9Pierrot/Espace_de_travail_phoenix/images/capteur_de_flamme.png

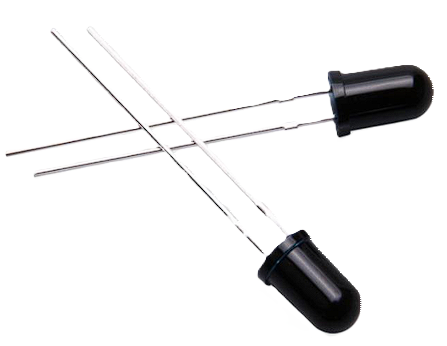
images/capteur_de_flamme.png
