9Pierrot/Espace_de_travail_phoenix/images/circuit.jpg

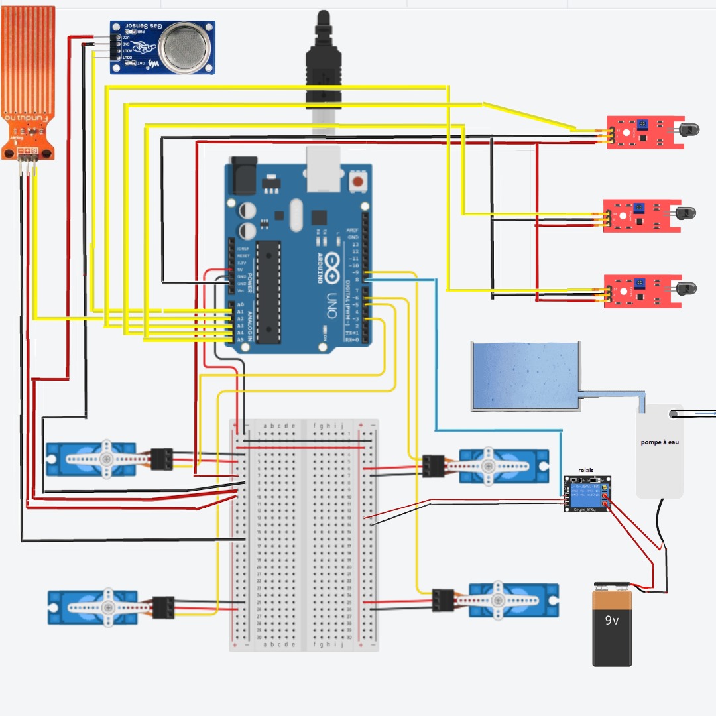
images/circuit.jpg
