9Pierrot/Espace_de_travail_phoenix/images/circuit_servo.png

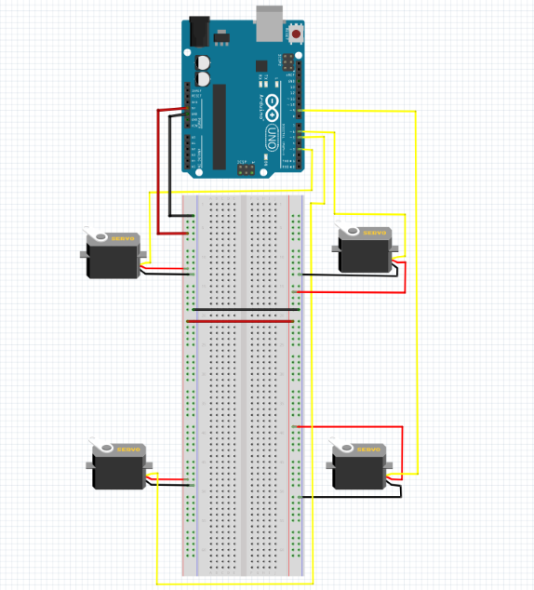
images/circuit_servo.png
