9Pierrot/Espace_de_travail_phoenix/images/dispositif_vue_angle.jpg

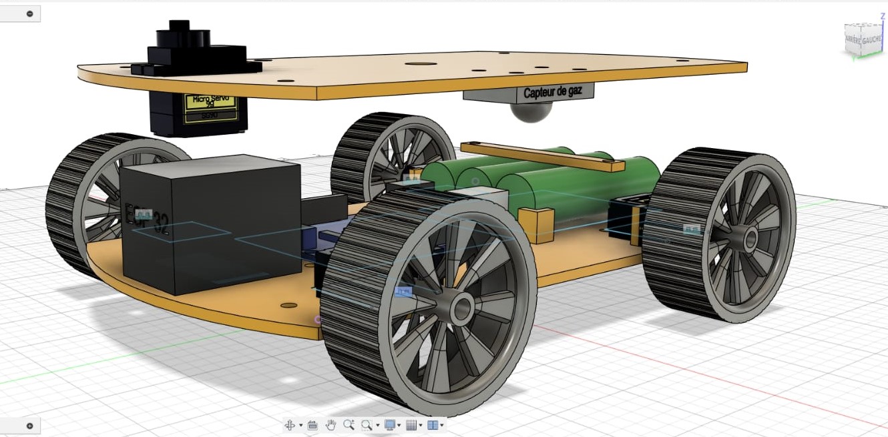
images/dispositif_vue_angle.jpg
