9Pierrot/Espace_de_travail_phoenix/images/etage_1(1).png

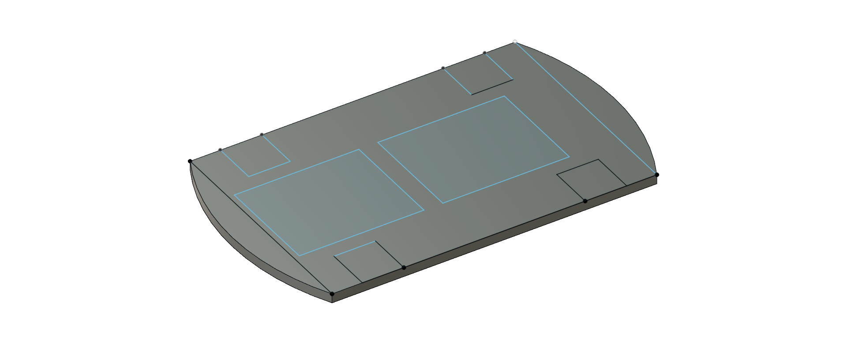
images/etage_1(1).png
