9Pierrot/Espace_de_travail_phoenix/images/etage_1.jpg

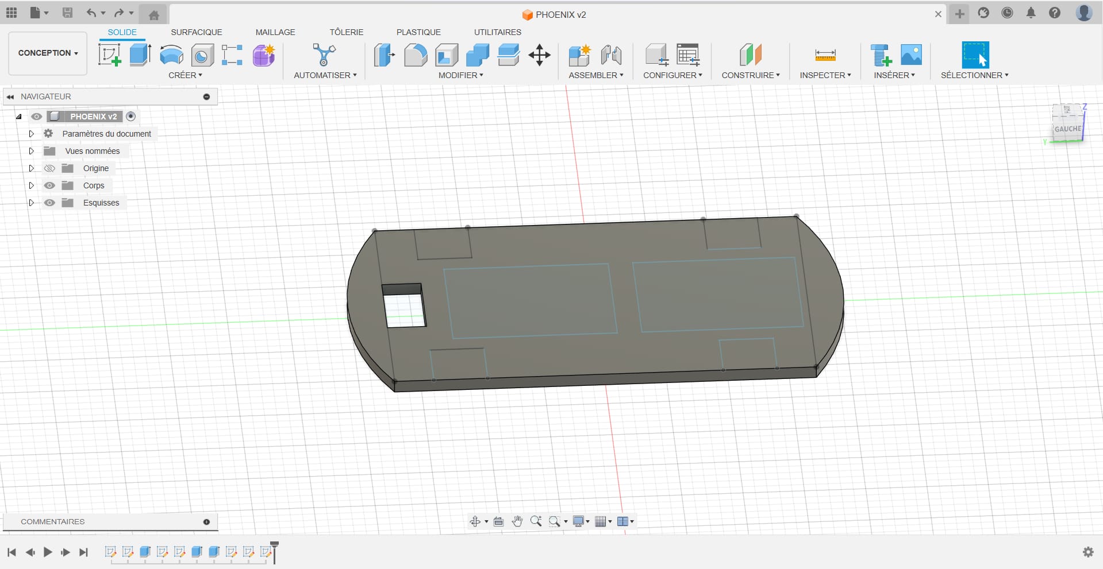
images/etage_1.jpg
