9Pierrot/Espace_de_travail_phoenix/images/etage_2.jpg

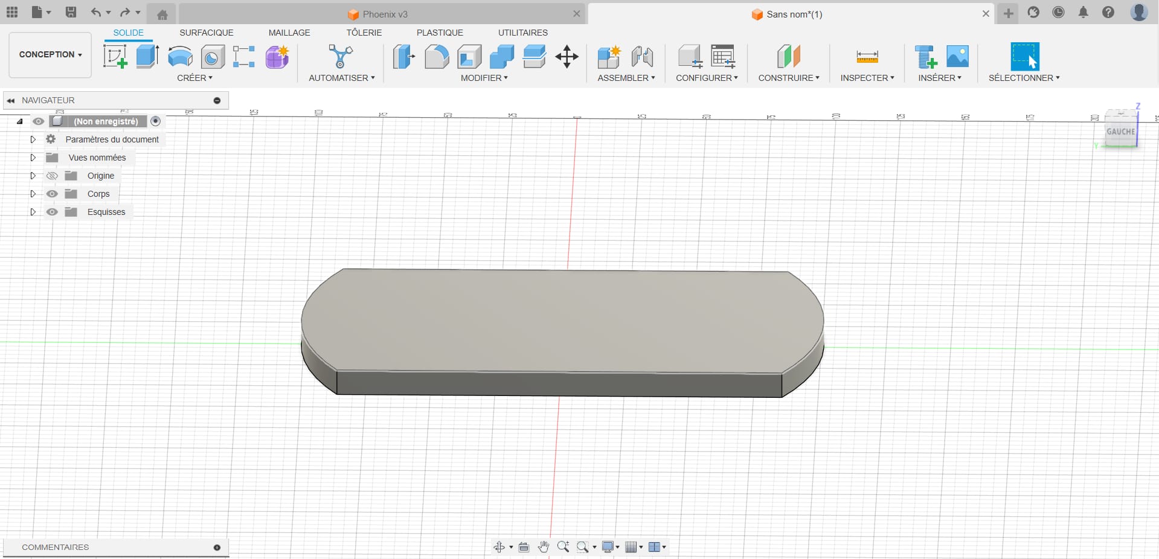
images/etage_2.jpg
