9Pierrot/Espace_de_travail_phoenix/images/img.png

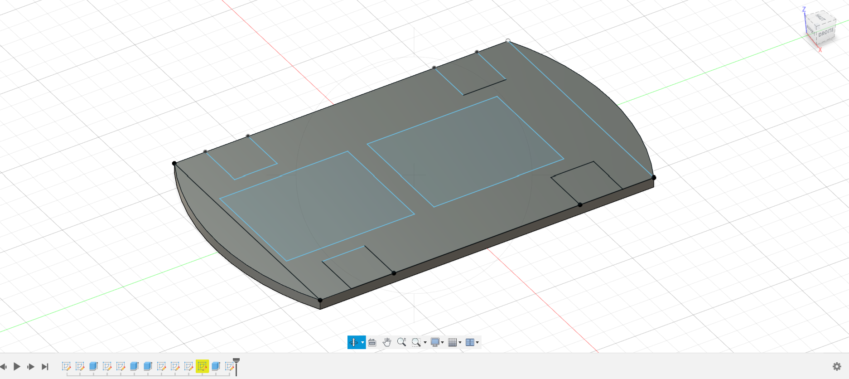
images/img.png
