9Pierrot/Espace_de_travail_phoenix/images/IMG_2295.JPG

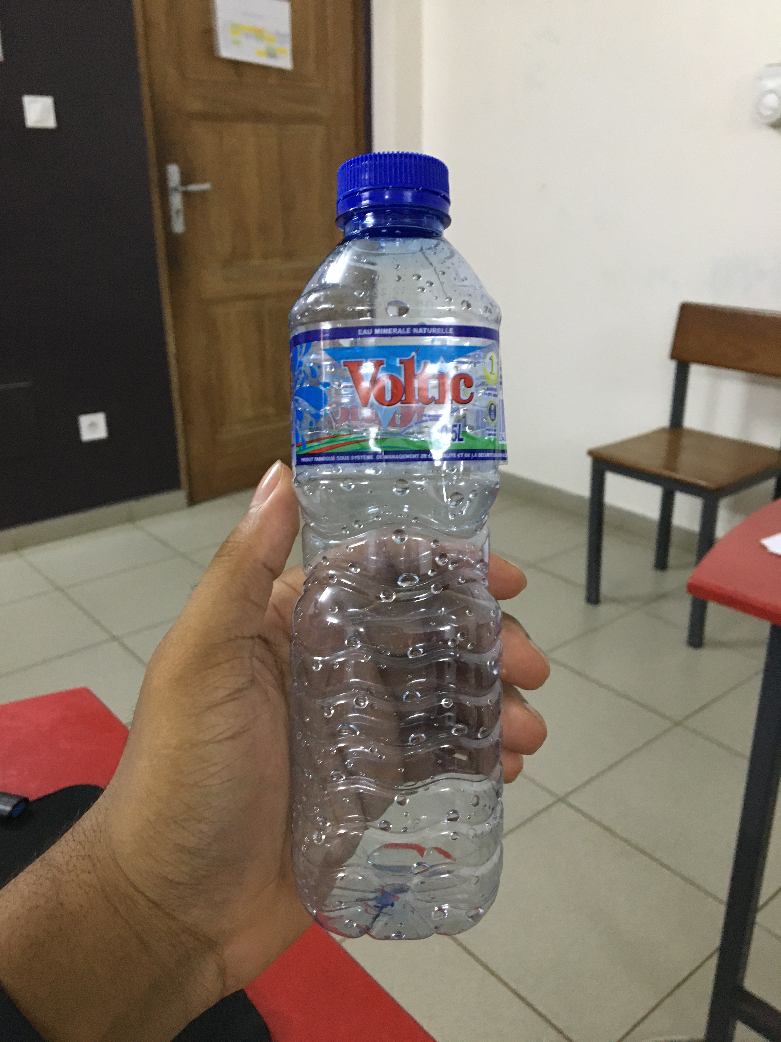
images/IMG_2295.JPG
