9Pierrot/Espace_de_travail_phoenix/images/MQ-6.jpeg

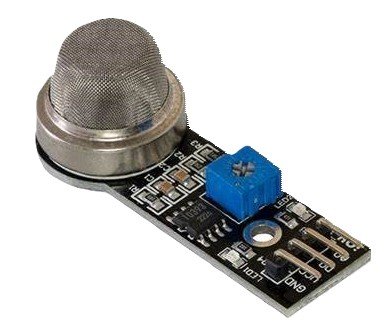
images/MQ-6.jpeg
