9Pierrot/Espace_de_travail_phoenix/images/pompe.webp

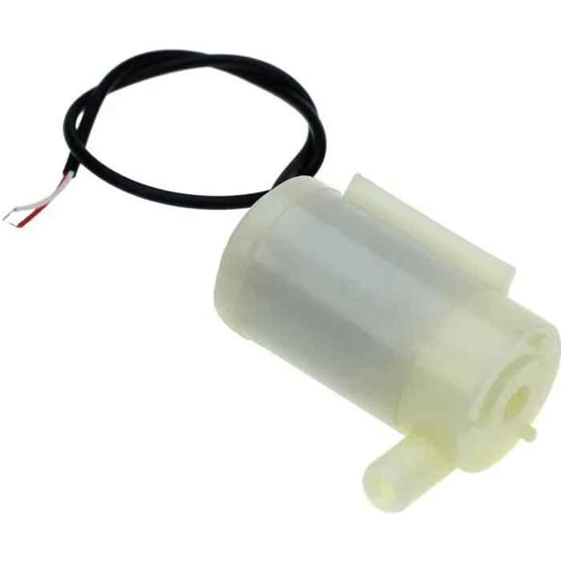
images/pompe.webp
