9Pierrot/Espace_de_travail_phoenix/images/pompe_mesures.jpg

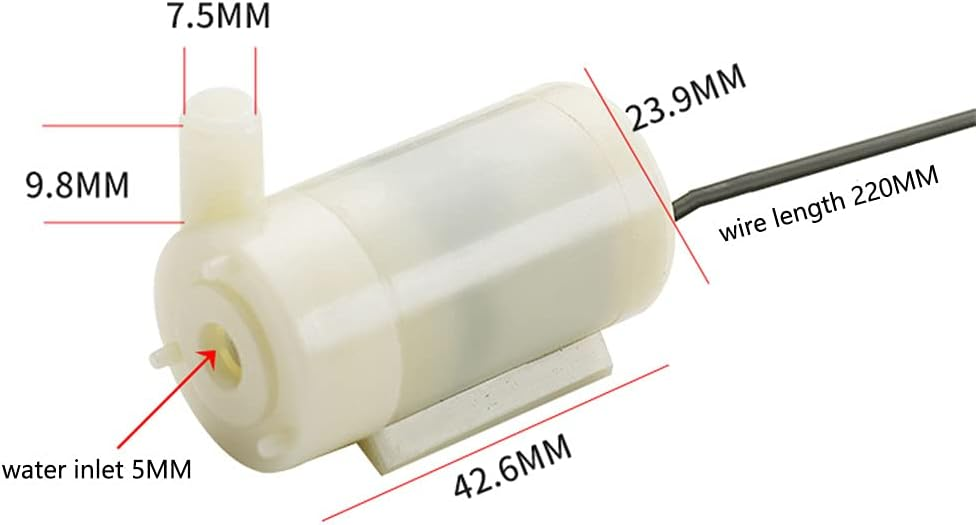
images/pompe_mesures.jpg
