9Pierrot/Espace_de_travail_phoenix/images/schema_phototransistor.png

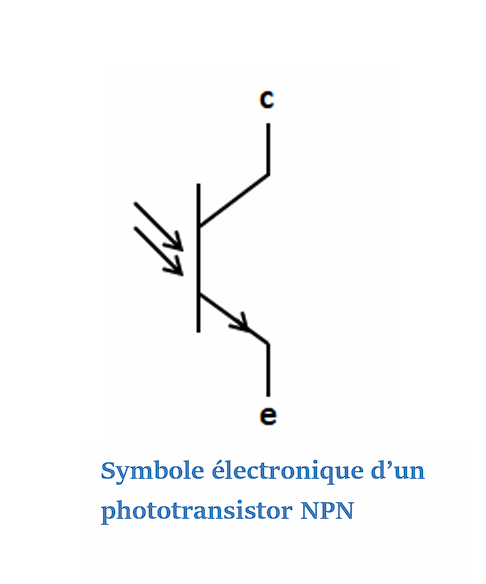
images/schema_phototransistor.png
