9Pierrot/Espace_de_travail_phoenix/images/servo.jpeg

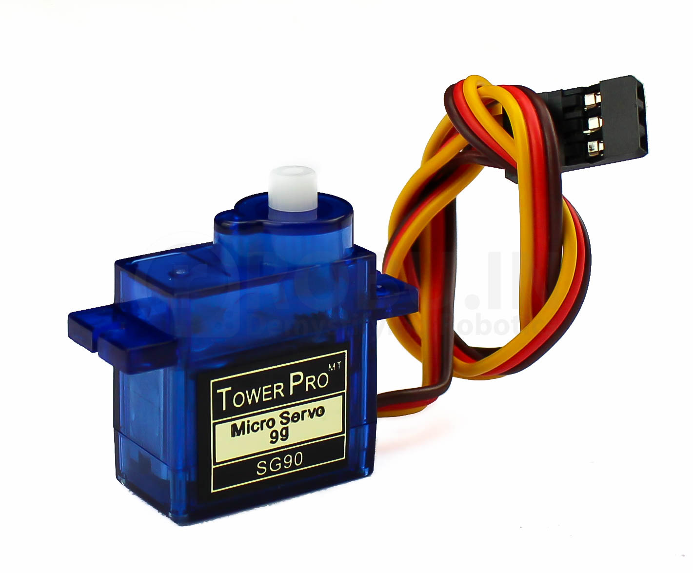
images/servo.jpeg
