9Pierrot/Espace_de_travail_phoenix/images/tuyau.jpg

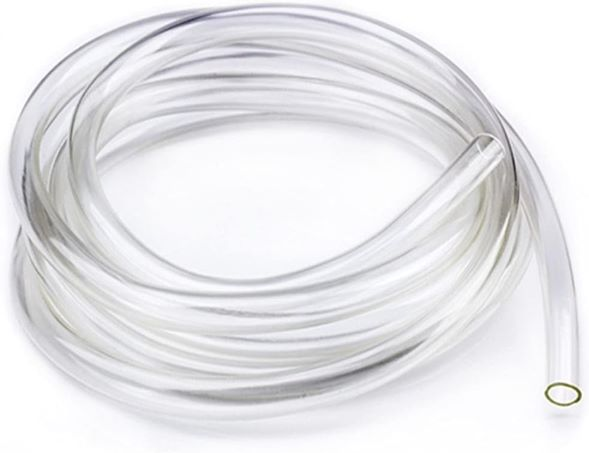
images/tuyau.jpg
