9Pierrot/Espace_de_travail_phoenix/modeles_3D/Phoenix 2eme plaque.png

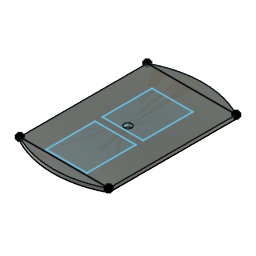
modeles_3D/Phoenix 2eme plaque.png
