9Pierrot/Espace_de_travail_phoenix/(list of files, cad)

Other CAD files:
modeles_3D/Phoenix 1ere plaque.f3d
modeles_3D/Phoenix 2eme plaque.f3d
