9Pierrot/Espace_de_travail_phoenix/sources/mq-02.pdf

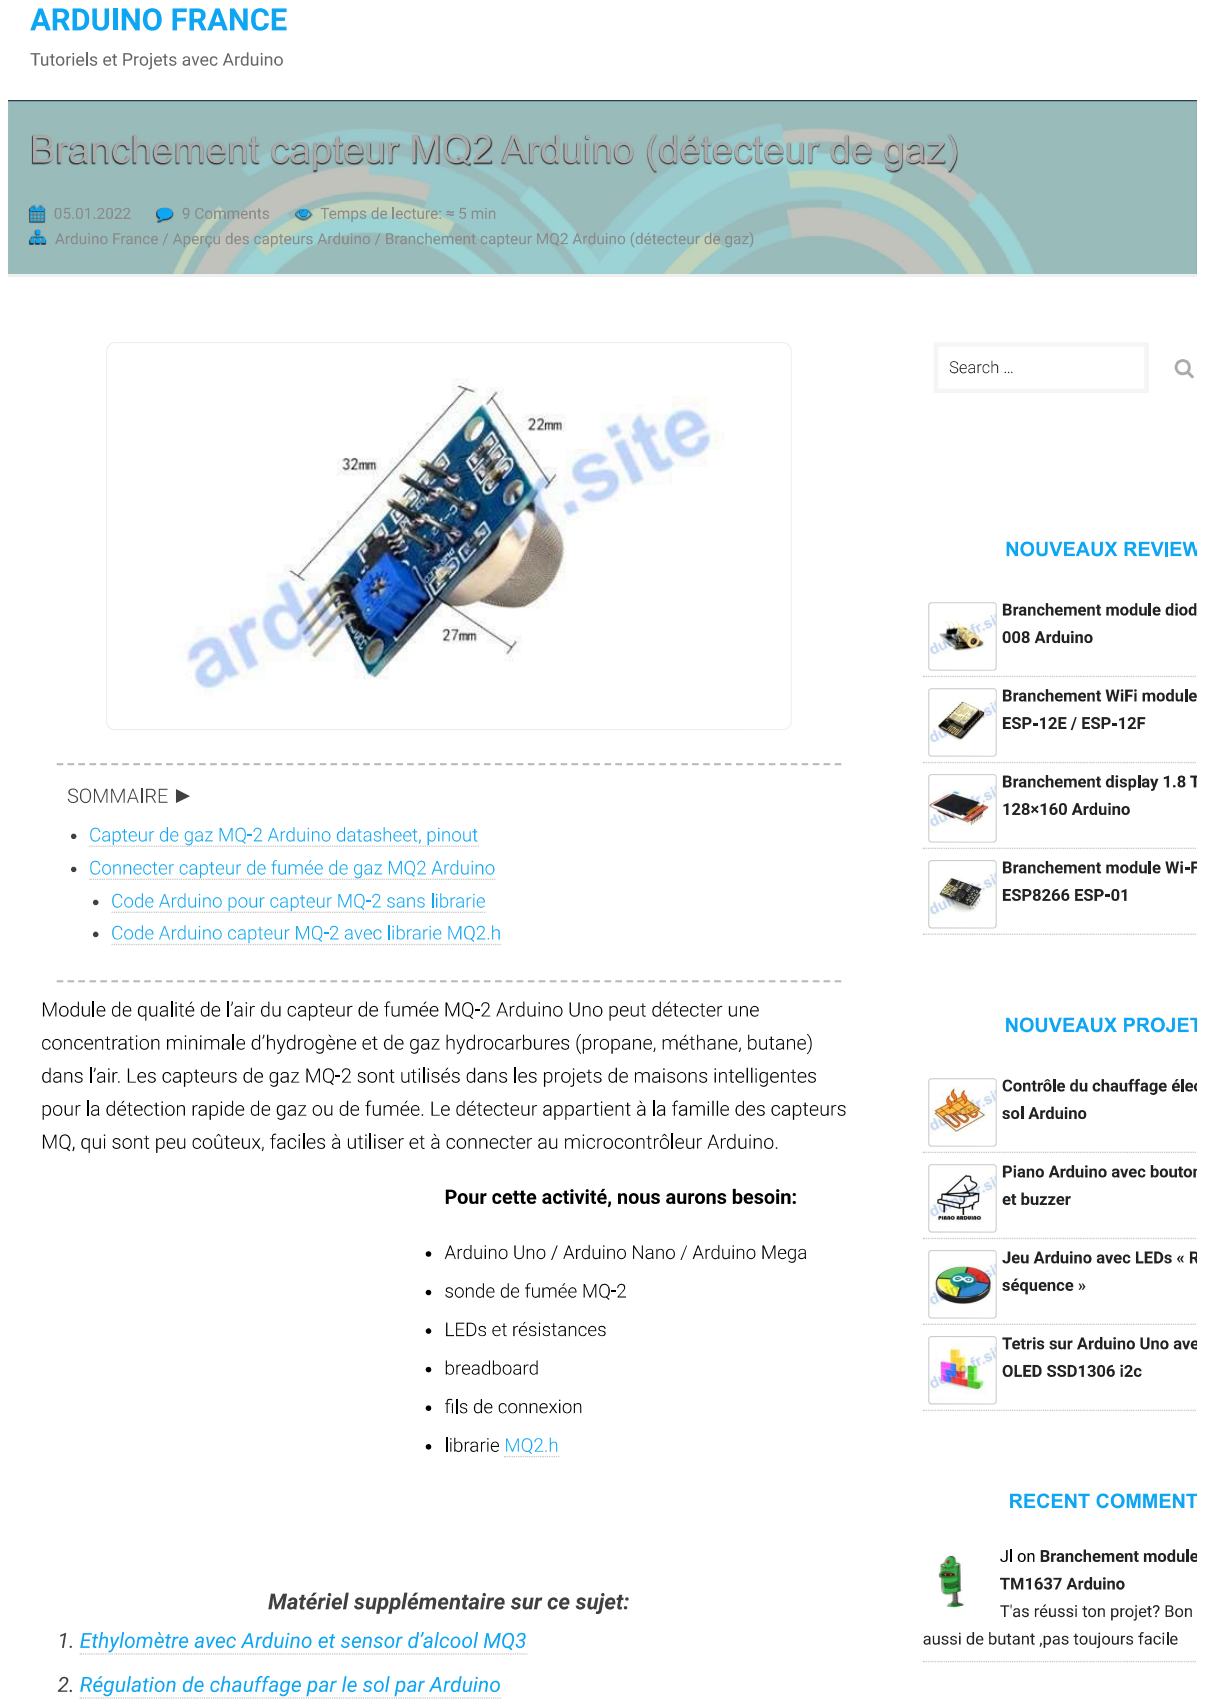
[picture p26: page 1]

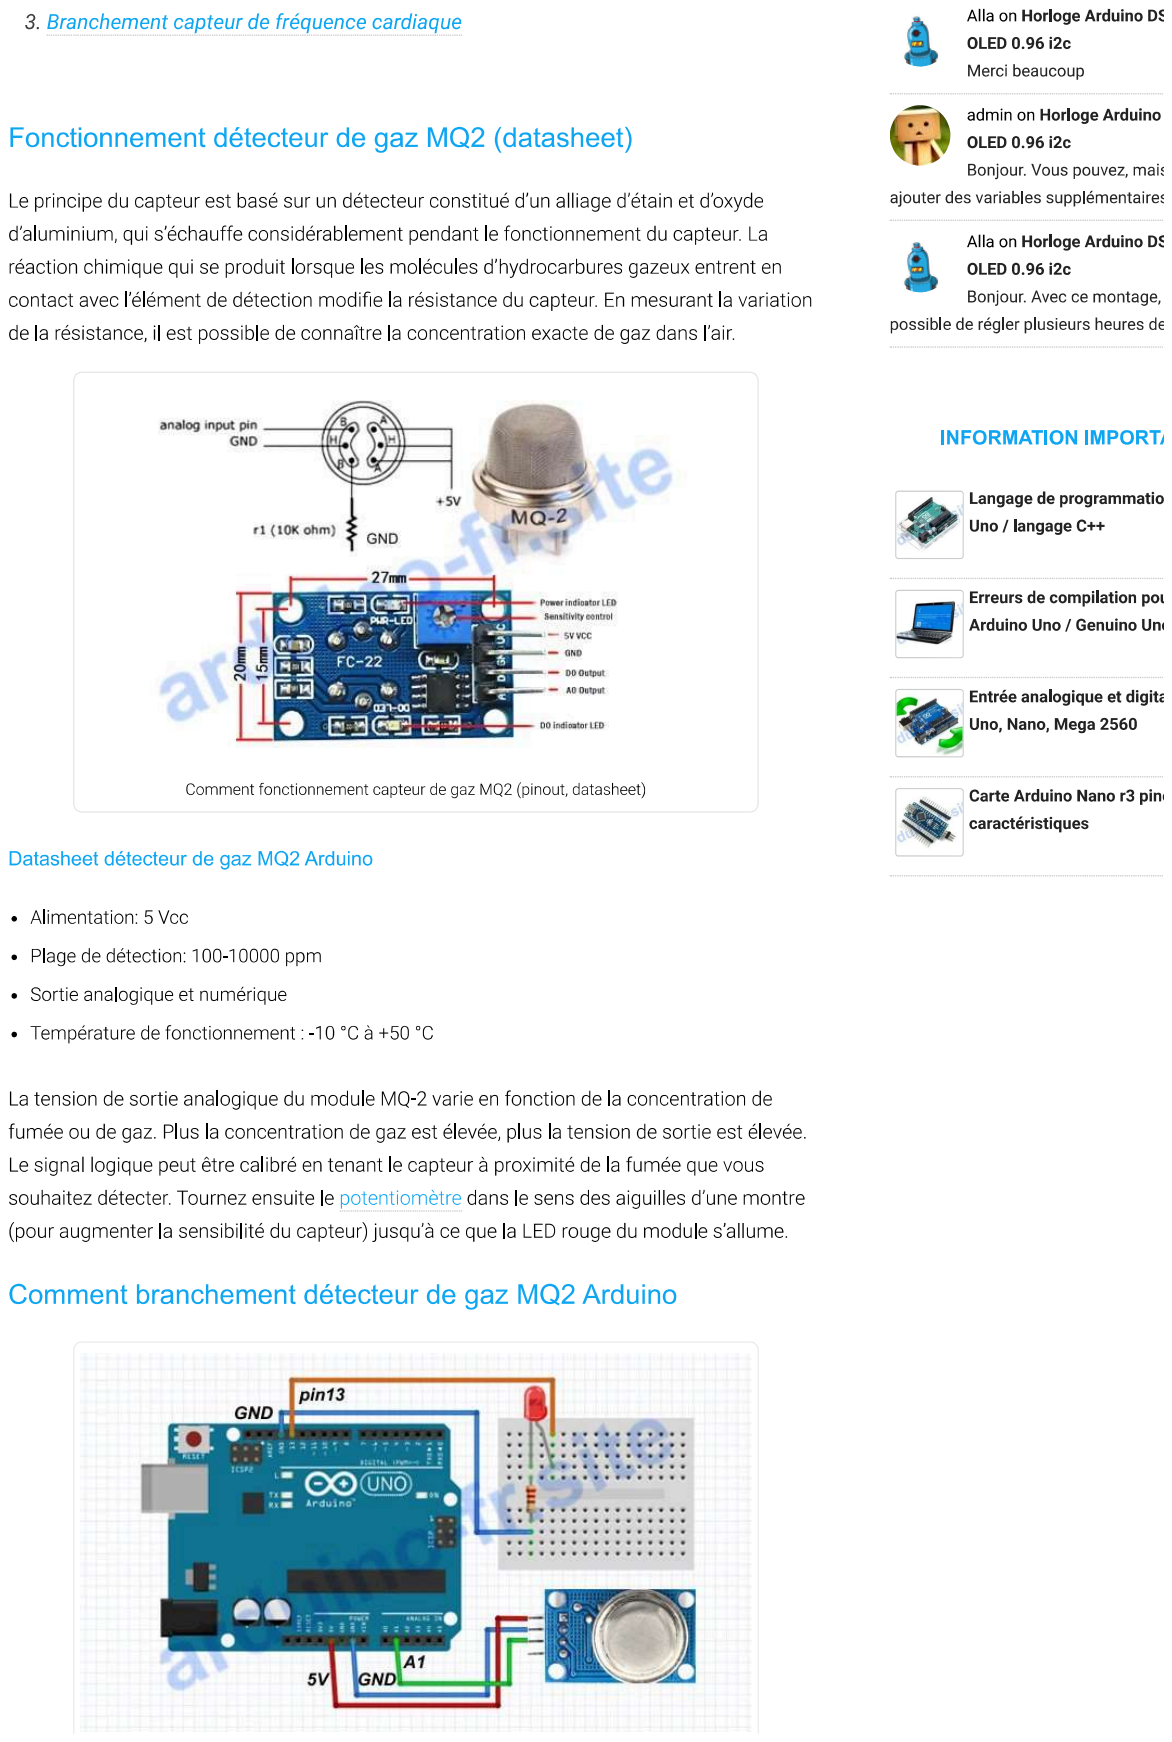
[picture p27: page 2]

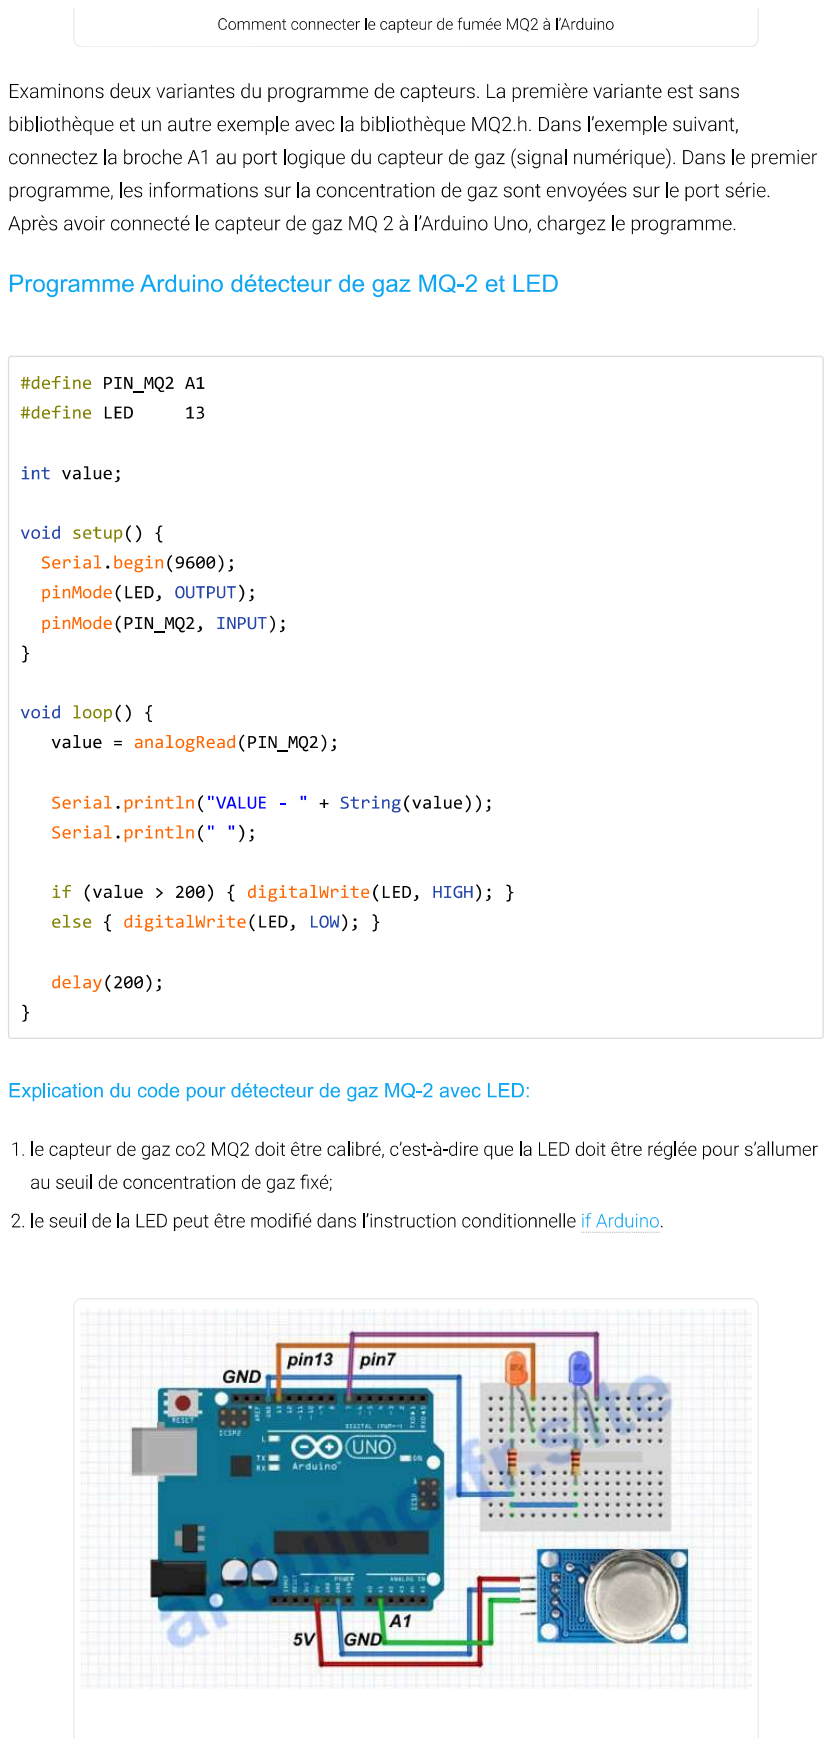
[picture p28: page 3]

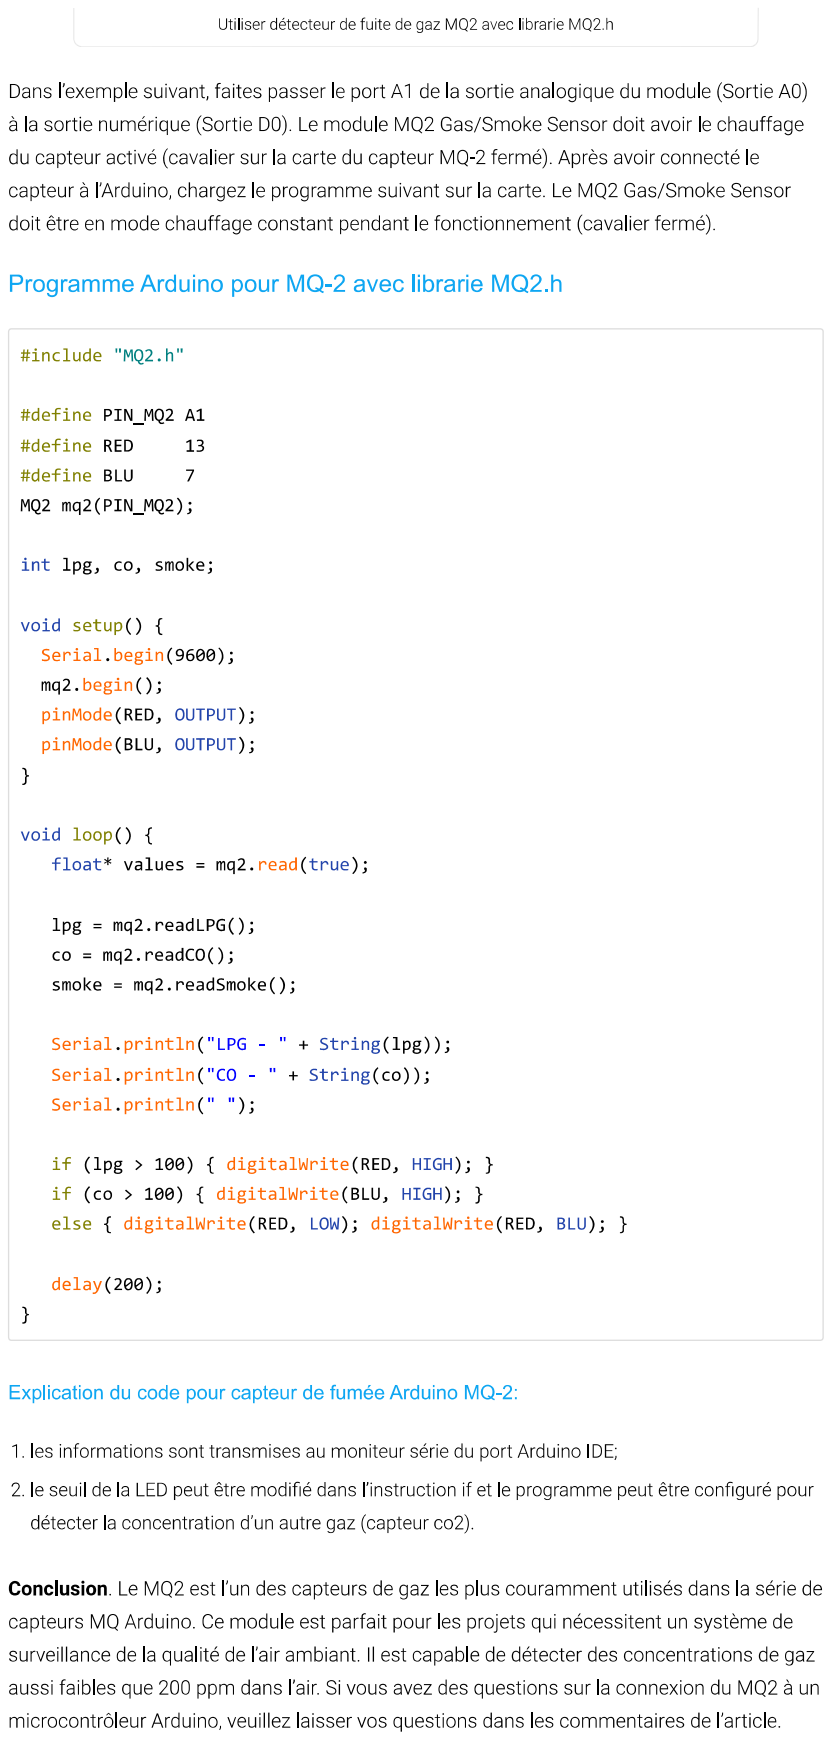
[picture p29: page 4]
