9Pierrot/Espace_de_travail_phoenix/(commit log)

2024-03-15 Ajout de la liste du matériel
2024-03-15 Ajout de sommaire
2024-03-15 Update README.md
    Edition des objectifs
2024-03-16 ajout des étapes
2024-03-16 Update README.md
    J'ai définit un plan pour la documentation qu'on complèteras au fur et à mesure qu'on avance
2024-03-16 Update README.md
    correction de la synthase
2024-03-17 Retouche de la mise en forme
2024-03-18 upload des images
2024-03-18 renommer les images
2024-03-18 insersion de l'image du 1er étage
2024-03-18 ajout de l'image du 2e étage
2024-03-18 renommé les images
2024-03-18 ajout des images, description des différentes étapes , comment améliorer , consulter des sites pour améliorer notre code à différentes endroits
2024-03-18 ajout de l'image du reservoir
2024-03-18 ajout du texte et corection de synthase
2024-03-18 complétion de la partie servo et ajout de l'extrait du code
2024-03-18 correction dans l'insersion des images
2024-03-19 ajout du dossier model_3D
    [Phoenix 1ere plaque.f3d, Phoenix 2eme plaque.f3d]
2024-03-19 insertion d'images
2024-03-19 pas de modif
2024-03-20 ajout de nouvelles sources et d'images
2024-03-20 ajout d'image des photorésistors et du code de détection de flamme
2024-03-20 ajout de l'image du circuit des servos
2024-03-20 modification des images
2024-03-21 édition des images
2024-03-21 Update README.md
    ajout de quelque éléments
2024-03-21 modification de dossiers
    [Phoenix 1ere plaque.f3d, Phoenix 2eme plaque.f3d]
2024-03-21 ajout de dossiers
    [Phoenix 1ere plaque.f3d, Phoenix 2eme plaque.f3d]
2024-03-21 insertion d'une vidéo test
2024-03-21 ajout d'une vidéo test des trois premiers objectifs
2024-03-22 images des modélisations
2024-03-23 mis à jour de la forme
    [Phoenix 1ere plaque.f3d, Phoenix 2eme plaque.f3d]
2024-03-23 ajout des circuits électronique ; des fonctionnalités
2024-03-23 rédiment ion des images
2024-03-23 capteur de gaz
